fabexdias/VoltageReader/imagens/vers1.0.jpeg

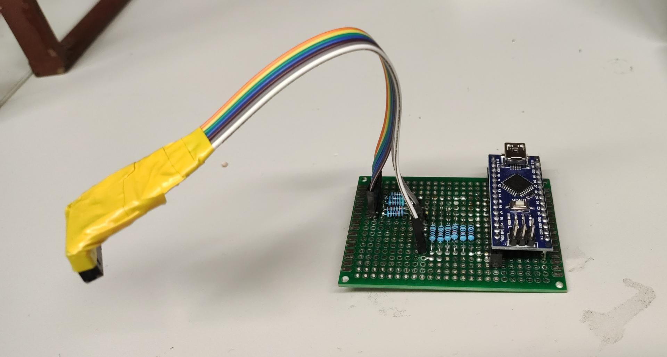
imagens/vers1.0.jpeg
