fabexdias/VoltageReader/imagens/conections.png

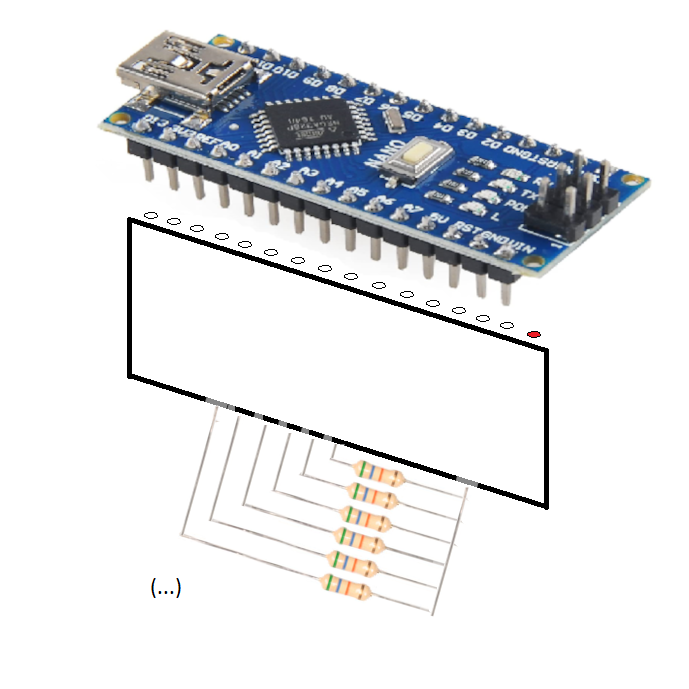
imagens/conections.png
