fabexdias/VoltageReader/README.md

# VoltageReader
Este protótipo foi criado para ler as tensões de um pack de bateria com 6 andares de tensão.
