fabexdias/VoltageReader/altium/vers1.0.pdf

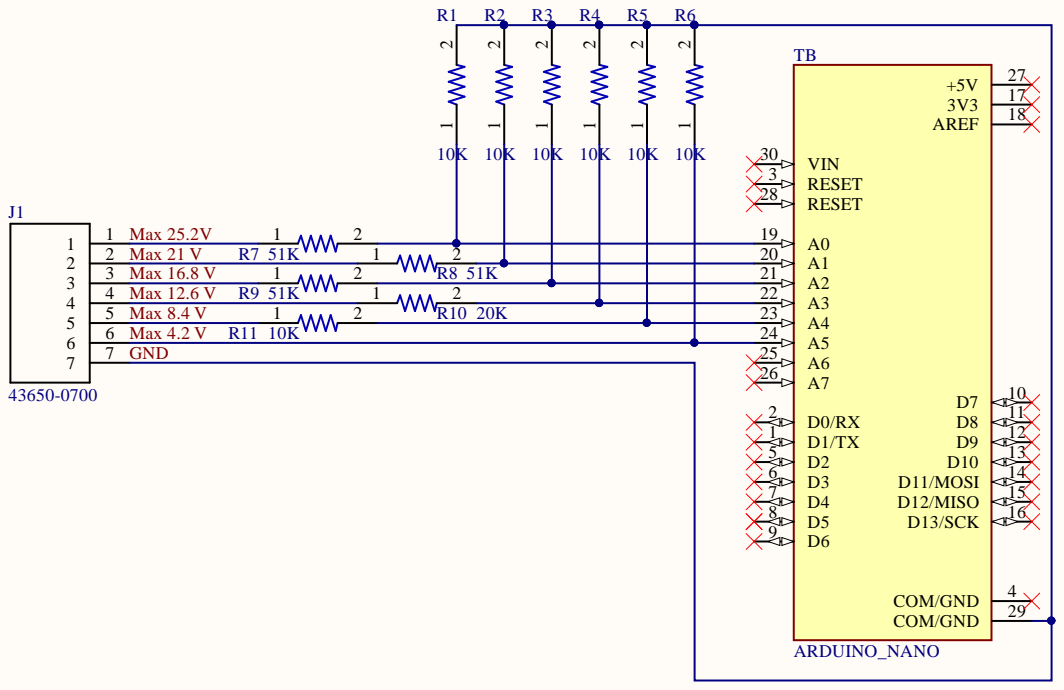
[picture p3: page 1]
