fabexdias/VoltageReader/(list of files, drawings)

Other design files:
altium/vers1.0.SchDoc
